xenbedded/pixel-c-support/hardware/debug_bridge_r2/outputs/ais-usbc.pdf

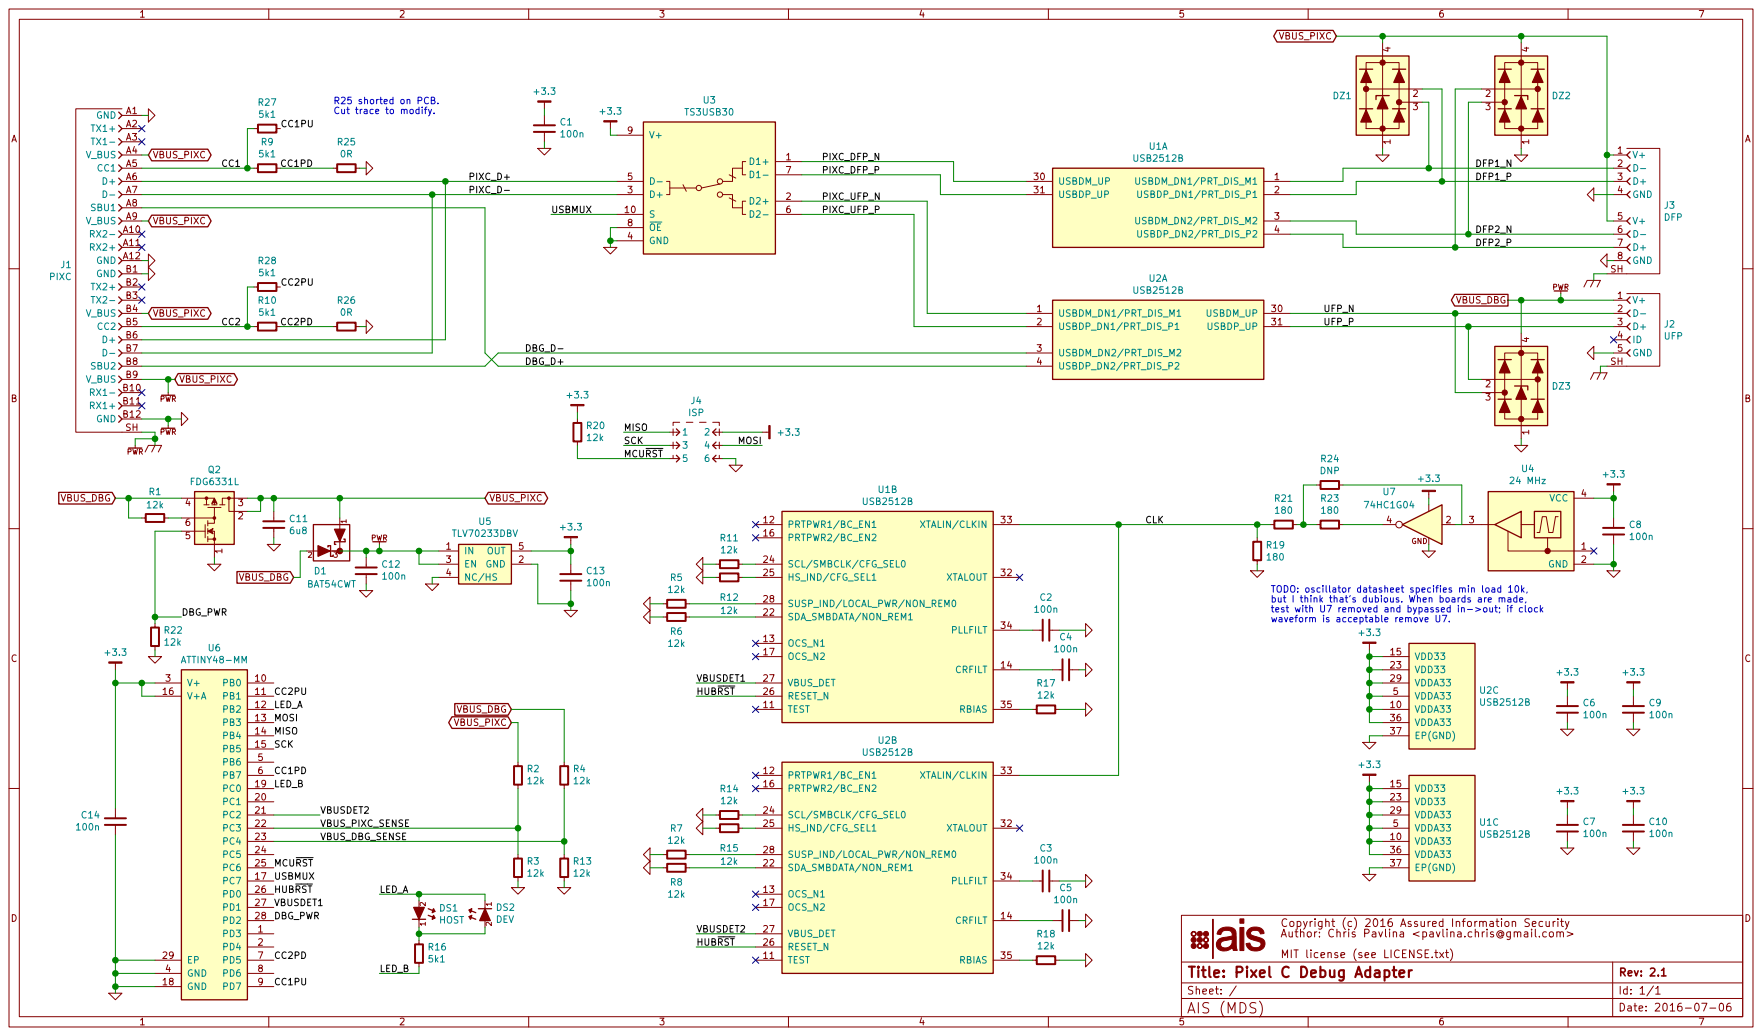
[picture p1: page 1]

74HC1G04 +3.3 TODO: oscillator datasheet specifies min load 10k, but I think that's dubious. When boards are made,

test with U7 removed and bypassed in->out; if clock
waveform is acceptable remove U7.

Copyright (c) 2016 Assured Information Security Author: Chris Pavlina <pavlina.chris@gmail.com>
