xenbedded/pixel-c-support/hardware/debug_bridge_r2/firmware/pin_io.h

// Copyright (c) 2016 Assured Information Security, Inc.
// Author: Chris Pavlina <pavlina.chris@gmail.com>
//
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
/// @file pin_io.h
/// Pin definitions and access macros.

#ifndef _PIN_IO_H
#define _PIN_IO_H 1

#include <avr/io.h>

#define PRT_LED_A           B
#define PIN_LED_A           2

#define PRT_LED_B           C
#define PIN_LED_B           0

#define PRT_USBMUX          C
#define PIN_USBMUX          7

#define PRT_HUBnRST         D
#define PIN_HUBnRST         0

#define PRT_DBG_PWR         D
#define PIN_DBG_PWR         2

#define PRT_VBUSDET1        D
#define PIN_VBUSDET1        1

#define PRT_VBUSDET2        C
#define PIN_VBUSDET2        2

#define PRT_VBUS_PIXC_SENSE C
#define PIN_VBUS_PIXC_SENSE 3
#define MUX_VBUS_PIXC_SENSE (3 << MUX0)

#define PRT_VBUS_DBG_SENSE  C
#define PIN_VBUS_DBG_SENSE  4
#define MUX_VBUS_DBG_SENSE  (4 << MUX0)

#define PRT_CC1PD           B
#define PIN_CC1PD           7

#define PRT_CC2PD           D
#define PIN_CC2PD           5

#define PRT_CC1PU           D
#define PIN_CC1PU           7

#define PRT_CC2PU           B
#define PIN_CC2PU           1

#define PRT_MCUnRST         C
#define PIN_MCUnRST         6


/// @internal helper macro for _CONCAT
#define _HELP_CONCAT(x, y) x ## y
/// @internal concatenate two macros
#define _CONCAT(x, y)  _HELP_CONCAT(x, y)

/// @internal extract and return the DDR register for a pin by name
#define _DDR_FOR_PIN(pin) _CONCAT(DDR, _CONCAT(PRT_, pin))

/// @internal extract and return the PORT register for a pin by name
#define _PORT_FOR_PIN(pin) _CONCAT(PORT, _CONCAT(PRT_, pin))

/// @internal extract and return the PIN register for a pin by name
#define _PIN_FOR_PIN(pin) _CONCAT(PIN, _CONCAT(PRT_, pin))

/// @internal extract and return the pin number for a pin by name
#define _NUM_FOR_PIN(pin) _CONCAT(PIN_, pin)



/// Configure a pin as output
#define POUTPUT(pin)    do { _DDR_FOR_PIN(pin)  |=   1 << (_NUM_FOR_PIN(pin)) ; } while (0)

/// Configure a pin as input
#define PINPUT(pin)     do { _DDR_FOR_PIN(pin)  &= ~(1 << (_NUM_FOR_PIN(pin))); } while (0)

/// Write 1 to a pin
#define PHIGH(pin)      do { _PORT_FOR_PIN(pin) |=   1 << (_NUM_FOR_PIN(pin)) ; } while (0)

/// Write 0 to a pin
#define PLOW(pin)       do { _PORT_FOR_PIN(pin) &= ~(1 << (_NUM_FOR_PIN(pin))); } while (0)

/// Write v to a pin
#define PVAL(pin, val)  do { if (val) { PHIGH(pin); } else { PLOW(pin); } } while (0)

/// Read a pin
#define PGET(pin)       ( _PIN_FOR_PIN(pin) & (1 << (_NUM_FOR_PIN(pin))) )

/// Read a pin's output value
#define PGETOUT(pin)    ( _PORT_FOR_PIN(pin) & (1 << (_NUM_FOR_PIN(pin))) )

#endif // _PIN_IO_H
