xenbedded/pixel-c-support/hardware/debug_bridge_r2/firmware/vbus.c

// Copyright (c) 2016 Assured Information Security, Inc.
// Author: Chris Pavlina <pavlina.chris@gmail.com>
//
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
#include "vbus.h"
#include "hardware.h"

#include <stdbool.h>
#include <util/atomic.h>

static volatile enum vbus_mode current_vbus_mode = VBUS_WAIT;

// Read the ADC samples and give an equivalent vbus mode from them.
// The result must be debounced afterward to use it meaningfully.
static enum vbus_mode get_vbus_mode(uint16_t vbus_pixc, uint16_t vbus_dbg);

static enum vbus_mode get_vbus_mode(uint16_t vbus_pixc, uint16_t vbus_dbg)
{
    bool pixc_valid = (vbus_pixc >= ADC_VAL(4.0));
    bool dbg_valid  = (vbus_dbg  >= ADC_VAL(4.0));

    static const uint16_t adc_diode_min = ADC_VAL(0.25);
    static const uint16_t adc_diode_max = ADC_VAL(0.85);

    bool diode = (vbus_dbg > (vbus_pixc - adc_diode_max)) &&
                 (vbus_dbg < (vbus_pixc - adc_diode_min)) &&
                 !is_charge_enabled();

    //  PIXC    DBG     DIODE   OUT
    //  0       0       0       VBUS_NONE
    //  0       0       1       VBUS_NONE (!)
    //  0       1       0       VBUS_DEBUG_ONLY
    //  0       1       1       VBUS_DEBUG_ONLY (!)
    //  1       0       0       VBUS_PIXC_ONLY
    //  1       0       1       VBUS_BOTH_DIODE
    //  1       1       0       VBUS_BOTH
    //  1       1       1       VBUS_BOTH_DIODE
    //
    //  (PIXC & !DBG & DIODE) could mean pixc's vbus was marginal, such that pixc
    //  vbus was valid but vbus-diode was not. This is still the diode case.

    if (!pixc_valid && !dbg_valid) {
        return VBUS_NONE;
    } else if (!pixc_valid && dbg_valid) {
        return VBUS_DEBUG_ONLY;
    } else if (pixc_valid && !dbg_valid && !diode) {
        return VBUS_PIXC_ONLY;
    } else if (pixc_valid && dbg_valid && !diode) {
        return VBUS_BOTH;
    } else if (pixc_valid && diode) {
        return VBUS_BOTH_DIODE;
    } else {
        // should not happen, all cases should be covered above.
        return VBUS_NONE;
    }
}


void vbus_adc_callback(uint16_t pixc, uint16_t dbg)
{
    static enum vbus_mode last_mode = VBUS_NONE;
    static const uint16_t debounce_top = 20u;
    static uint16_t debounce_count = 0u;

    // Get the vbus mode from the samples, then debounce it.
    enum vbus_mode mode = get_vbus_mode(pixc, dbg);

    if (mode == last_mode) {
        ++debounce_count;
        if (debounce_count == debounce_top) {
            debounce_count = 0;
            current_vbus_mode = mode;
        }
    } else {
        debounce_count = 0;
        last_mode = mode;
    }
}


enum vbus_mode get_current_vbus_mode()
{
    enum vbus_mode mode;

    ATOMIC_BLOCK(ATOMIC_RESTORESTATE) {
        mode = current_vbus_mode;
    }

    return mode;
}
