xenbedded/pixel-c-support/(commit log)

2016-05-31 HW: add initial PCB layout
    [ais-usbc.kicad_pcb, ais-usbc.sch]
2016-05-31 HW: new layout, fix power bug
    [ais-usbc.kicad_pcb, ais-usbc.sch]
2016-05-31 HW: add missing footprint library table
2016-05-31 HW: final? layout
    [ais-usbc.kicad_pcb, ais-usbc.sch]
2016-05-31 HW: clean up schematic
    [ais-usbc.kicad_pcb, ais-usbc.sch]
2016-05-31 HW: merge clock nets, remove extra terminations
    [ais-usbc.kicad_pcb, ais-usbc.sch]
2016-05-31 HW: add reset pullup
    [ais-usbc.kicad_pcb, ais-usbc.sch]
2016-05-31 HW: add missing pulldown on DBG_PWR
    [ais-usbc.kicad_pcb, ais-usbc.sch]
2016-05-31 HW: (FW) switch compile to use LTO
2016-05-31 HW: (FW) add hardware and pin definitions files
2016-05-31 HW: (FW) set ADC prescaler
2016-05-31 HW: (FW) handle ADC samples using ISR callback
2016-05-31 HW: (FW) add tick timer and blink LED for error
    [hardware.c, hardware.h, main.c]
2016-05-31 HW: (FW) reset USB hubs when state changes
    [hardware.c, hardware.h, main.c]
2016-05-31 HW: (FW) add PVAL macro to set pin without writing out the branch
2016-05-31 HW: (FW) factor out reset_hubs_on_change
    [main.c]
2016-05-31 HW: (FW) fix bug: forgot to track last mode
    [main.c]
2016-05-31 HW: (FW) add 'program' and 'fuses' make targets
2016-05-31 HW: set LED part number
    [ais-usbc.sch]
2016-05-31 HW: correct solder paste stencil cutouts
    [ais-usbc.kicad_pcb]
2016-05-31 HW: fix pinout of ATTINY24A-MU (13, 14 swapped)
    [ais-usbc.kicad_pcb]
2016-05-31 HW: buffer clock to meet oscillator load requirement
    [ais-usbc.kicad_pcb, ais-usbc.sch]
2016-05-31 HW: add license and readme
    [ais-usbc.sch]
2016-05-31 HW: fix revision ID (should be 2.0, not 1.0)
    [ais-usbc.kicad_pcb, ais-usbc.sch]
2016-05-31 HW: add PDF and Gerbers
    [ais-usbc-B.Cu.gbl, ais-usbc-B.Mask.gbs, ais-usbc-B.Paste.gbp, ais-usbc-B.SilkS.gbo, ais-usbc-Edge.Cuts.gm1, ais-usbc-F.Cu.gtl, ais-usbc-F.Mask.gts, ais-usbc-F.Paste.gtp]
2016-05-31 HW: (FW) fix faulty condition for detecting diode passthrough
    [vbus.c]
2016-05-31 HW: fix swapped debug USB pair
    [ais-usbc-B.Cu.gbl, ais-usbc-B.Mask.gbs, ais-usbc-B.Paste.gbp, ais-usbc-B.SilkS.gbo, ais-usbc-Edge.Cuts.gm1, ais-usbc-F.Cu.gtl, ais-usbc-F.Mask.gts, ais-usbc-F.Paste.gtp]
2016-06-03 HW: add TODO for optimization after test
    [ais-usbc.sch]
2016-06-03 HW: add and use standard AIS worksheet
    [ais-usbc.sch]
2016-06-03 HW: implement ERC and fix an error it reported
    Power pin on ISP header was not connected.
    [ais-usbc-B.Cu.gbl, ais-usbc-B.Mask.gbs, ais-usbc-B.Paste.gbp, ais-usbc-B.SilkS.gbo, ais-usbc-Edge.Cuts.gm1, ais-usbc-F.Cu.gtl, ais-usbc-F.Mask.gts, ais-usbc-F.Paste.gtp]
2016-06-03 HW: update regulator component to attach NC pin
    [ais-usbc-B.Cu.gbl, ais-usbc-B.Mask.gbs, ais-usbc-B.Paste.gbp, ais-usbc-B.SilkS.gbo, ais-usbc-Edge.Cuts.gm1, ais-usbc-F.Cu.gtl, ais-usbc-F.Mask.gts, ais-usbc-F.Paste.gtp]
2016-06-03 HW: fix pin ordering error on USB mux
    [ais-usbc-B.Cu.gbl, ais-usbc-B.Mask.gbs, ais-usbc-B.Paste.gbp, ais-usbc-B.SilkS.gbo, ais-usbc-Edge.Cuts.gm1, ais-usbc-F.Cu.gtl, ais-usbc-F.Mask.gts, ais-usbc-F.Paste.gtp]
2016-06-03 HW: add nonpopulated bypass around clock buffer
    [ais-usbc-B.Cu.gbl, ais-usbc-B.Mask.gbs, ais-usbc-B.Paste.gbp, ais-usbc-B.SilkS.gbo, ais-usbc-Edge.Cuts.gm1, ais-usbc-F.Cu.gtl, ais-usbc-F.Mask.gts, ais-usbc-F.Paste.gtp]
2016-06-03 HW: tune USB trace lengths
    [ais-usbc-B.Cu.gbl, ais-usbc-B.Mask.gbs, ais-usbc-B.Paste.gbp, ais-usbc-B.SilkS.gbo, ais-usbc-Edge.Cuts.gm1, ais-usbc-F.Cu.gtl, ais-usbc-F.Mask.gts, ais-usbc-F.Paste.gtp]
2016-06-03 HW: fix missing redundant trace on inner layer
    [ais-usbc-B.Cu.gbl, ais-usbc-B.Mask.gbs, ais-usbc-B.Paste.gbp, ais-usbc-B.SilkS.gbo, ais-usbc-Edge.Cuts.gm1, ais-usbc-F.Cu.gtl, ais-usbc-F.Mask.gts, ais-usbc-F.Paste.gtp]
2016-06-03 HW: improve ground connectivity of USB host ports
    [ais-usbc-B.Cu.gbl, ais-usbc-B.Mask.gbs, ais-usbc-B.Paste.gbp, ais-usbc-B.SilkS.gbo, ais-usbc-Edge.Cuts.gm1, ais-usbc-F.Cu.gtl, ais-usbc-F.Mask.gts, ais-usbc-F.Paste.gtp]
2016-06-06 HW: (FW) fix swapped CC configuration for host mode
    [main.c]
2016-06-06 HW: (FW) avoid possible call to 0x0 if callback not initialized
    [hardware.c]
2016-06-13 HW: change CC pull scheme to ensure delivery of Vbus from PixC
    Fixed pulldown is routed through jumper footprints, with the pulldown for CC2
    hard-shorted across the jumper. This allows moving the hard pulldown from CC2
    to CC1 if testing reveals a mistake was made in selecting the correct CCn pin.
    Pullups are added to counter the pulldowns, to allow the microcontroller to
    simulate a detach (open-circuit) event.
    Additionally, the microcontroller is upgraded to ATTINY48 (more pins) to allow
    it to control these. This commit does not modify the firmware accordingly.
    [ais-usbc-B.Cu.gbl, ais-usbc-B.Mask.gbs, ais-usbc-B.Paste.gbp, ais-usbc-B.SilkS.gbo, ais-usbc-Edge.Cuts.gm1, ais-usbc-F.Cu.gtl, ais-usbc-F.Mask.gts, ais-usbc-F.Paste.gtp]
2016-06-13 HW: (FW) Adjust pin map and config registers for new microcontroller
2016-06-13 HW: (FW) "Disconnect" on CC pins when changing modes
    The PixC pulls the CC pins to an open-circuit voltage of 1.65V (half 3.3V), so
    we also do this through a combination of pullup and pulldown when simulating a
    disconnect event.
2016-06-13 HW: fix error in silkscreen (pin 1 indicator in wrong corner)
    [ais-usbc-B.Cu.gbl, ais-usbc-B.Mask.gbs, ais-usbc-B.Paste.gbp, ais-usbc-B.SilkS.gbo, ais-usbc-Edge.Cuts.gm1, ais-usbc-F.Cu.gtl, ais-usbc-F.Mask.gts, ais-usbc-F.Paste.gtp]
2016-06-21 HW: add assembly diagram
    [ais-usbc-B.Cu.gbl, ais-usbc-B.Mask.gbs, ais-usbc-B.Paste.gbp, ais-usbc-B.SilkS.gbo, ais-usbc-Edge.Cuts.gm1, ais-usbc-F.Cu.gtl, ais-usbc-F.Fab.gbr, ais-usbc-F.Mask.gts]
2016-06-28 HW: (FW) fix incorrect pin mapping
    [pin_io.h]
2016-06-28 HW: (FW) minor fix to ADC value computation
    [hardware.h]
2016-06-28 HW: (FW) output MCU clock on unused pin for troubleshooting
2016-06-28 HW: (FW) fix incorrect ADC reference selection
    [hardware.c]
2016-06-28 HW: (FW) fix lost state in stateful function
    [main.c]
2016-06-29 HW: (FW) adjust Makefile for debugging
    - Switch to -Og optimization level for easier debug
    - Add -std=gnu11; Atmel's compiler complains otherwise
    - Copy output to the name Atmel Studio expects
2016-06-29 HW: (FW) initialize properly to avoid loss of power
    [main.c]
2016-06-29 HW: (FW) initialize directly to device mode when only debug port is powered
    Because the PixC does not provide power unless in host mode, detecting
    connection of the PixC by monitoring vbus did not work.
    [main.c]
2016-06-29 HW: (FW) allow lower threshold for detecting power switch diode drop
2016-06-29 HW: (FW) shorten debounce threshold to reduce delay
    [vbus.c]
2016-06-29 HW: (FW) swap CC pin behavior
    [main.c]
2016-06-29 HW: (FW) fix loss of power on mode switch
    [main.c]
2016-07-06 HW: swap shorted and open jumpers; update to rev 2.1
    Testing discovered that the CC jumper footprints had been shorted incorrectly
    and required modification. This jumper configuration is necessary to ensure
    that the PixC delivers power on Vbus at start.
    [ais-usbc-B.Cu.gbl, ais-usbc-B.Mask.gbs, ais-usbc-B.Paste.gbp, ais-usbc-B.SilkS.gbo, ais-usbc-Edge.Cuts.gm1, ais-usbc-F.Cu.gtl, ais-usbc-F.Fab.gbr, ais-usbc-F.Mask.gts]
