xenbedded/pixel-c-support/(notices)

Notices in the files:
hardware/debug_bridge_r2/ais-usbc.sch:
MIT license (see LICENSE.txt)
